thecasterian/STM32-FC/Document/Protocol.xlsx

Sheet: Definitions
Abbreviation List
Abbreviation | Description
ACC | Accelerometer
GYRO | Gyroscope
MAG | Magnetometer
KF | Kalman filter
RPY | Roll, pitch, yaw angle
PWM | Pulse width modulation
RF | Radio frequency

Sheet: Protocol Structure
Protocol Structure
Position | Length | Field Name | Description | Type | Value | Note
0 | 1 | STX | Start Byte | uint8_t | 0x02
1 | 1 | TYP | Packet Type | uint8_t | 0 -- 255 | Refer to the packet type list
2 | 2 | LEN | Data Length | uint16_t | 0 -- 1023
4 | LEN | DAT | Data | - | -
LEN + 4 | 2 | CRC | Data CRC | uint16_t | 0 -- 65535 | CRC-16/MODBUS value of DAT
LEN + 6 | 1 | ETX | End Byte | uint8_t | 0x03
Total Length | LEN + 7 | - | - | - | -
Packet Type List
TYP | Definition |  | Description
0x90 | TYP_CMD |  | Command packet
0x91 | TYP_RESP |  | Response packet
0x92 | TYP_STRM |  | Streaming packet

Sheet: Command Packet
Data Structure
Position | Length | Field Name | Description | Type | Value | Note
0 | 1 | CMD | Command ID | uint8_t | 0 -- 255 | Refer to the command list
1 | LEN - 1 | ARG | Arguments | - | -
Command List
CMD | ARG
 | Length | Definition | Description | Type | Value | Note
0xA0 | 1 | CMD_PWM | PWM on/off | bool | 0, 1 | 0: off; 1: on default: off
0xA1 | 8 | CMD_THROT | Front left throttle | uint8_t | 0 -- 100 | Unit: % default: All 0%
 |  |  | Front right throttle
 |  |  | Rear left throttle
 |  |  | Rear right throttle

Sheet: Response Packet
Data Structure
Position | Length | Field Name | Description | Type | Value | Note
0 | 1 | ERR | Error code | uint8_t | 0 -- 255 | Refer to the error code list
Error Code List
Error Code |  | Definition |  | Description
0xE0 |  | ERR_OK |  | No error Only for ACK | No errorOnly for ACK | No errorOnly for ACK
0xE1 |  | ERR_ETX_MIS |  | ETX is missing
0xE2 |  | ERR_CRC_MIS |  | Data CRC mismatch
0xE3 |  | ERR_TYP_INVAL |  | Packet type is invalid
0xE4 |  | ERR_CMD_INVAL |  | Command ID is invalid
0xE5 |  | ERR_LEN_INVAL |  | LEN does not match with the required number of arguments
0xE6 |  | ERR_ARG_INVAL |  | Argument value is invalid

Sheet: Streaming Packet
Data Structure
Position | Length | Field Name | Description | Type | Value | Note
0 | 1 | FNO | Number of streaming fields | uint8_t | 0 -- 255
1 | FNO | FID | Streaming field IDs | uint8_t[FNO] | -
FNO + 1 | LEN - FNO - 1 | SRD | Streaming data | - | - | Refer to the streaming field list
Streaming Field List
Field ID | Length | Definition | Description | Data Type | Unit | Note
0x00 | 1 | DAT_MODE | Current mode | uint8_t | -
0x01 | 4 | DAT_TICK | Current tick | uint32_t | -
0x10 | 12 | DAT_ACC | Acceleration | float[3] | m/s2
0x11 | 12 | DAT_ANG | Angular velocity | float[3] | rad/s
0x12 | 12 | DAT_MAG | Magnetic field | float[3] | uT
0x18 | 12 | DAT_RAW_ACC | Raw acceleration | float[3] | m/s2 | Raw ACC measurement without calibration in sensor frame
0x19 | 12 | DAT_RAW_ANG | Raw angular velocity | float[3] | rad/s | Raw GYRO measurement without calibration in sensor frame
0x1A | 12 | DAT_RAW_MAG | Raw magnetic field | float[3] | uT | Raw MAG measurement without calibration in sensor frame
0x20 | 16 | DAT_KF_QUAT | Kalman-filtered quaternion | float[4] | -
0x21 | 12 | DAT_KF_RPY | Kalman-filtered roll, pitch, yaw | float[3] | rad
0x28 | 16 | DAT_MEAS_QUAT | Measured quaternion | float[4] | - | Quaternion calculated from ACC and MAG measurements
0x29 | 12 | DAT_MEAS_RPY | Measured roll, pitch, yaw | float[3] | rad | RPY calculated from ACC and MAG measurements
0x30 | 40 | DAT_COV_STATE | Covariance matrix of state estimate | float[10] | - | Only upper triangular part; row major order
0x31 | 40 | DAT_COV_PROC | Covariance matrix of process noise | float[10] | - | Only upper triangular part; row major order
0x40 | 32 | DAT_RF | RF received data channel 1 -- 16 | uint16_t[16] | -
