thecasterian/STM32-FC/Hardware/Rev_B/Custom_Parts/LIS2MDLTR.step

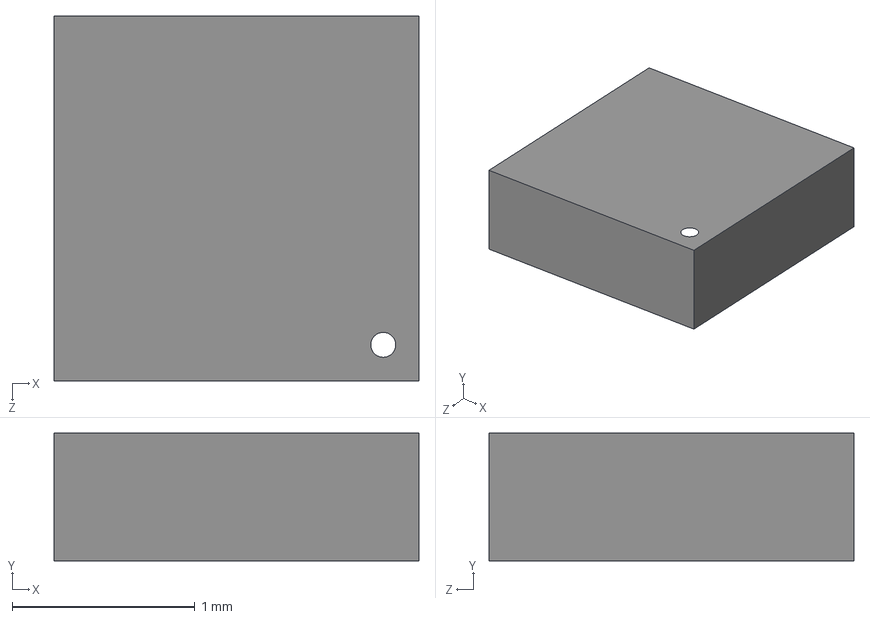
[picture p1: CAD file, 2022-11-16]
Hardware/Rev_B/Custom_Parts/LIS2MDLTR.step
2.00 x 0.7 x 2.00 mm
