thecasterian/STM32-FC/Hardware/Rev_B/Custom_Parts/BMI088.step

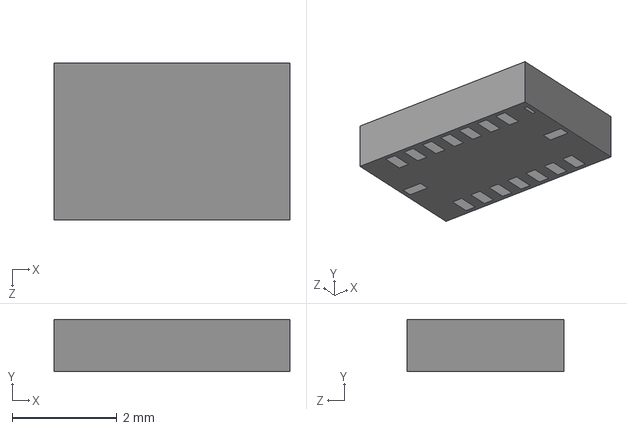
[picture p2: CAD file, 2022-11-16]
Hardware/Rev_B/Custom_Parts/BMI088.step
4.50 x 1.00 x 3.00 mm
