thecasterian/STM32-FC/Hardware/Rev_B/Custom_Parts/TS-1187A-B-A-B.step

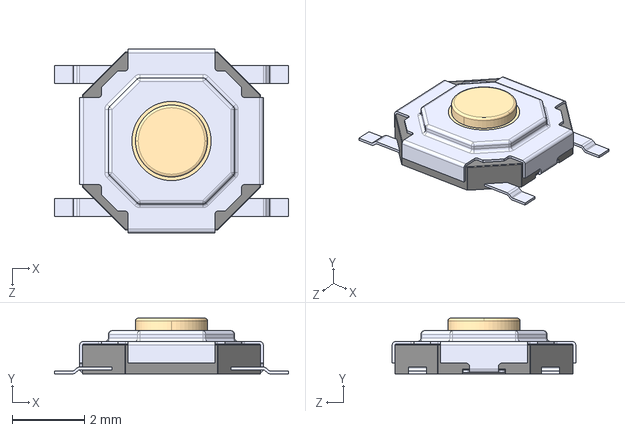
[picture p3: CAD file, 2022-11-16]
Hardware/Rev_B/Custom_Parts/TS-1187A-B-A-B.step
6.50 x 1.55 x 5.10 mm
