thecasterian/STM32-FC/Hardware/Rev_B/Custom_Parts/530480310.stp

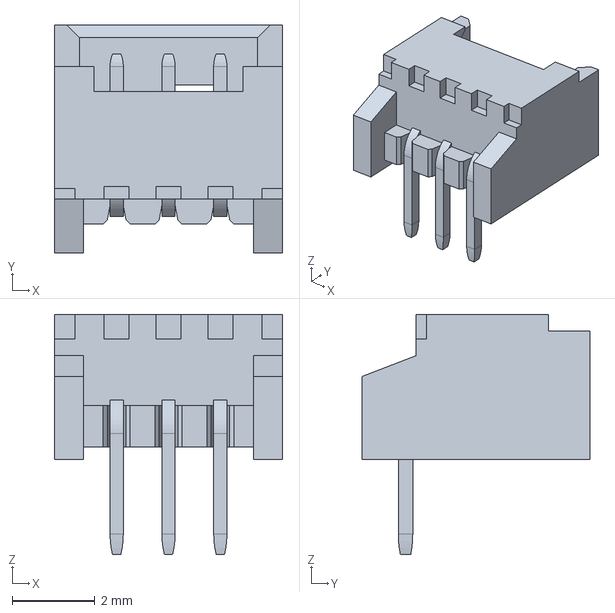
[picture p4: CAD file, 2022-12-27]
Hardware/Rev_B/Custom_Parts/530480310.stp
5.50 x 5.50 x 5.80 mm
