thecasterian/STM32-FC/Hardware/Rev_B/Custom_Parts/1050170001.stp

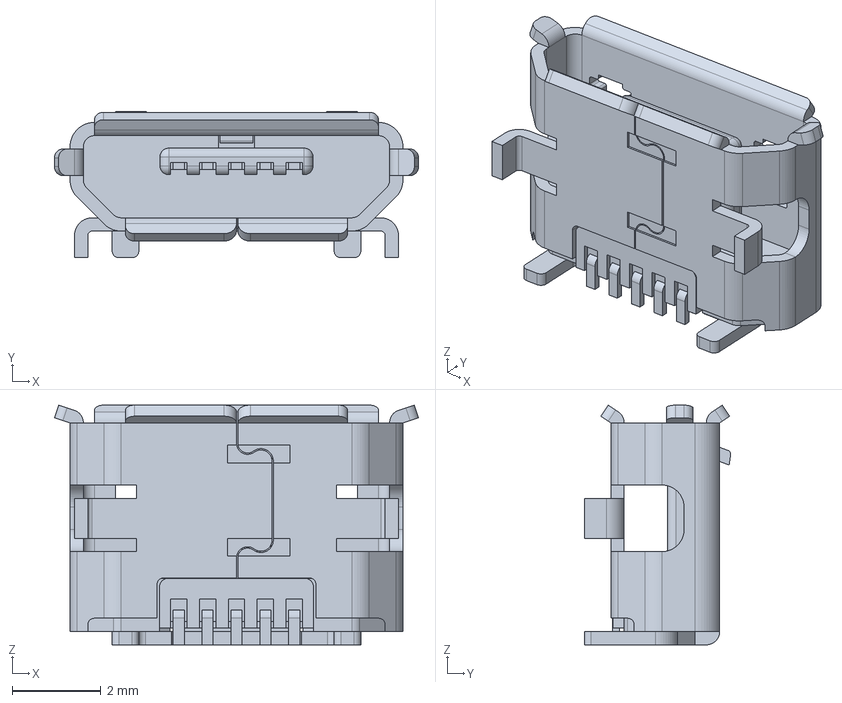
[picture p5: CAD file, 2022-11-16]
Hardware/Rev_B/Custom_Parts/1050170001.stp
8.20 x 3.30 x 5.40 mm
