thecasterian/STM32-FC/Hardware/Rev_B/STM32-FC.kicad_pcb

## KiCad design Hardware/Rev_B/STM32-FC.kicad_pcb (2022-12-27)

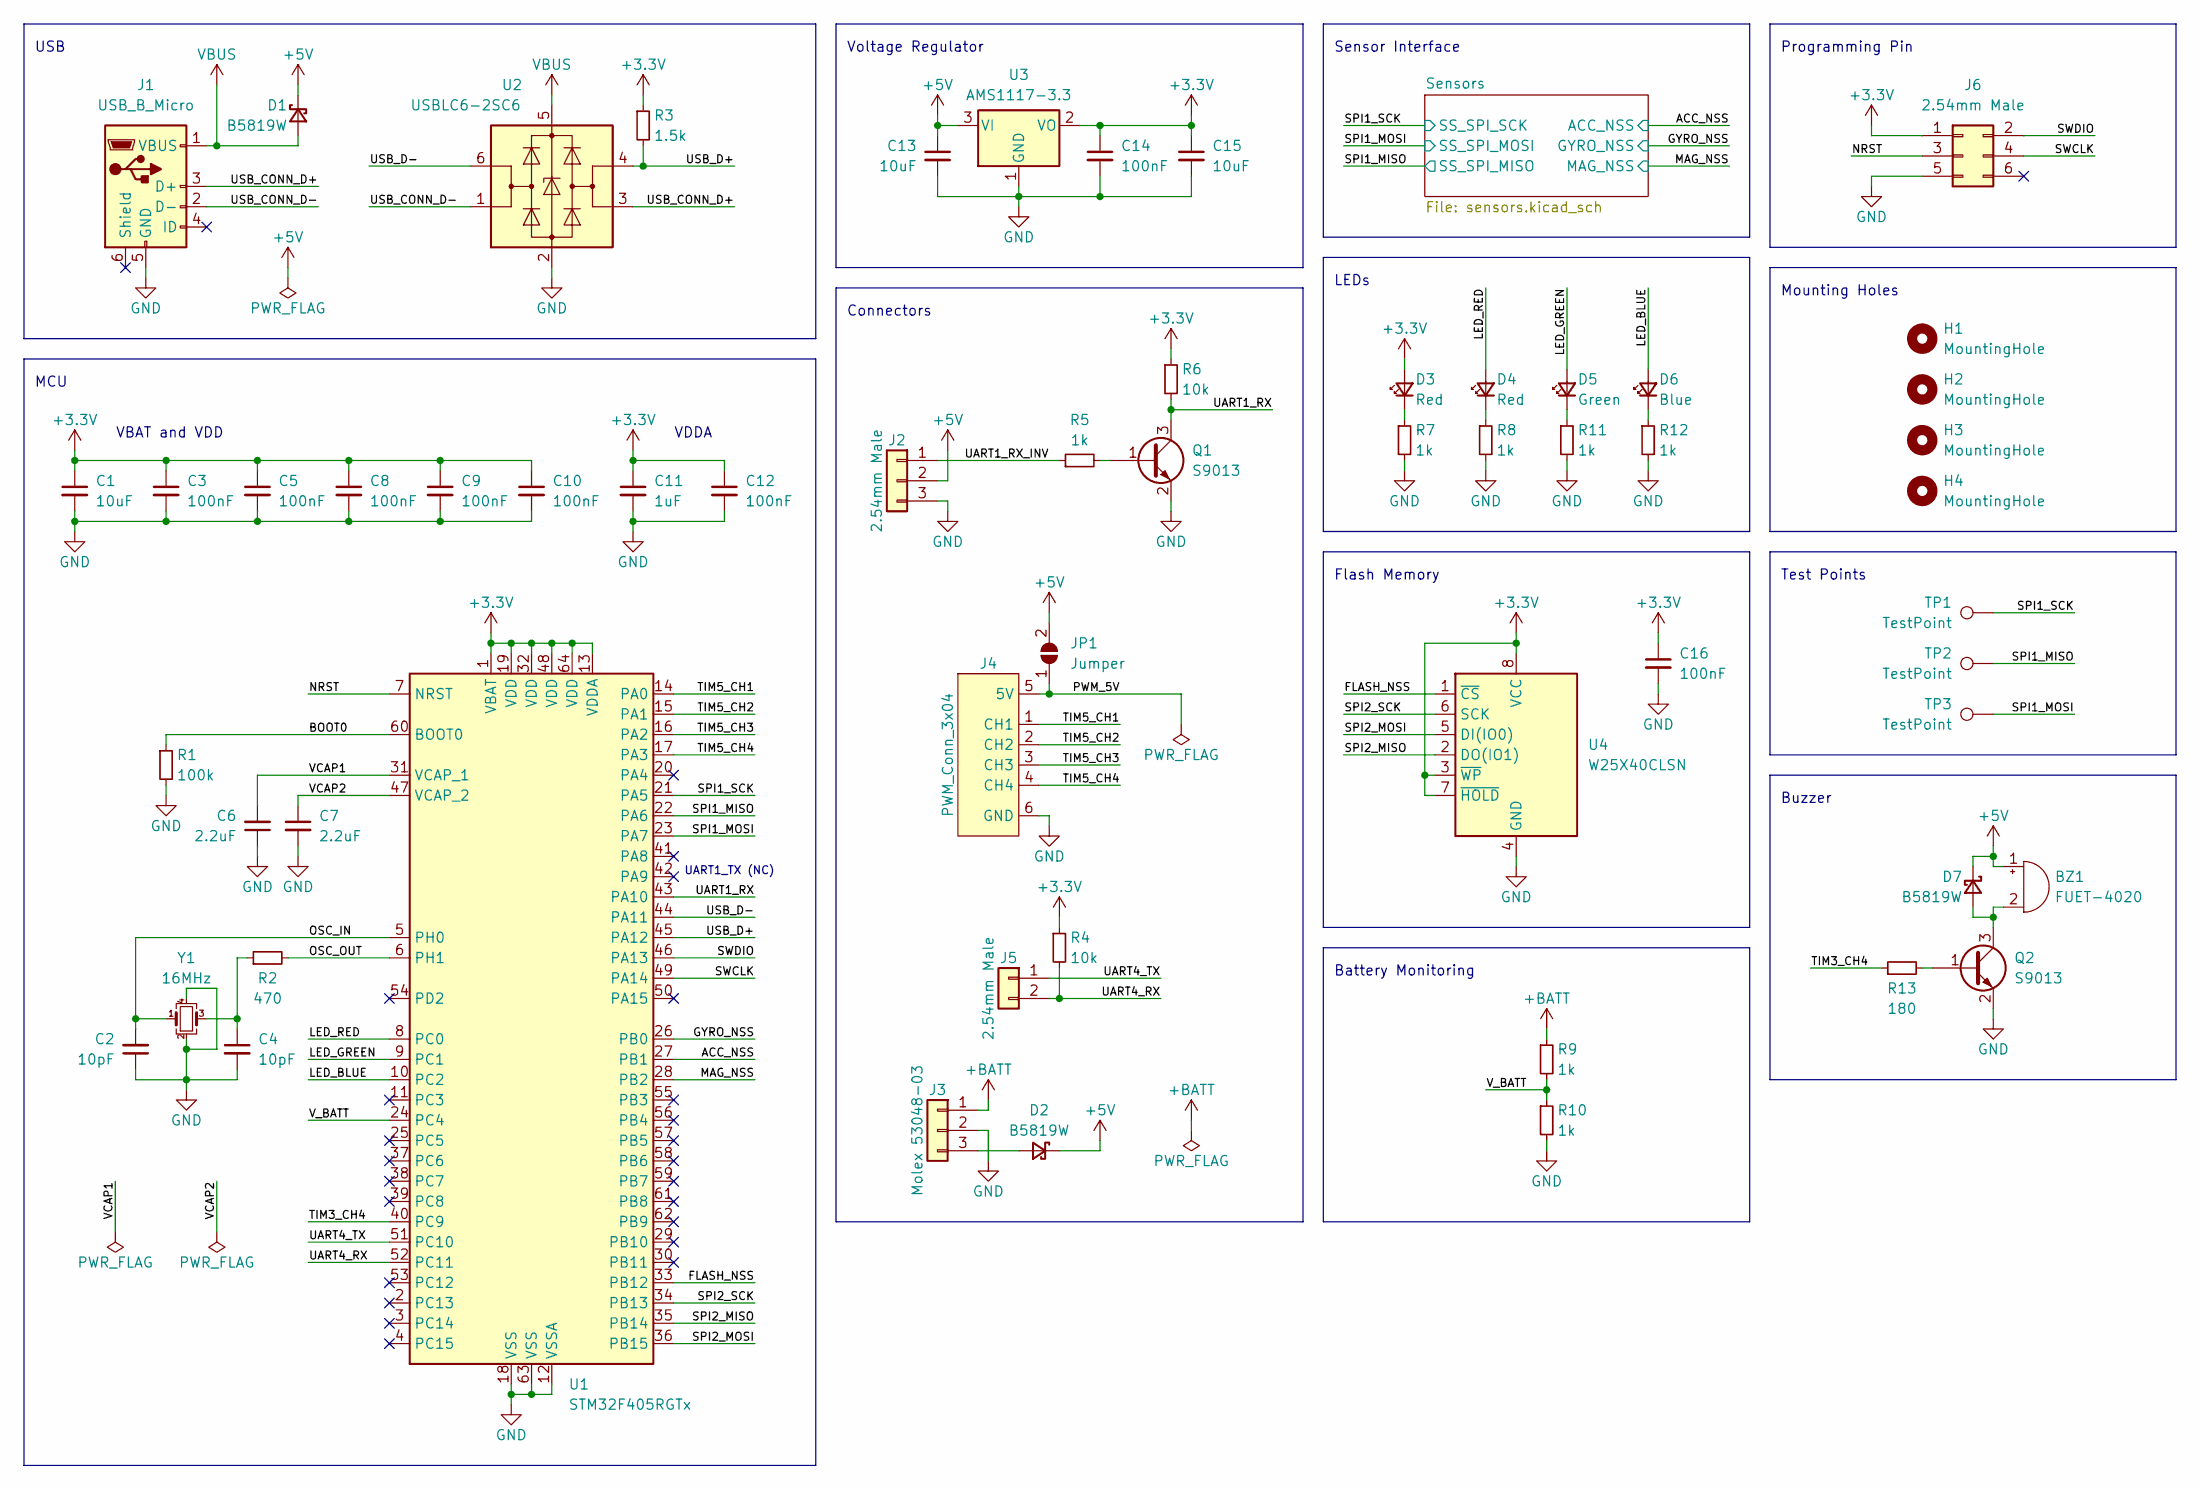
[picture p6: schematic STM32-FC.kicad_sch, STM32 Flight Controller]

Parts:
BZ1: FUET-4020
C1: 10uF; C_0402_1005Metric; LCSC C19702
C2, C4: 10pF; C_0402_1005Metric
C3, C5, C8, C9, C10, C12: 100nF; C_0402_1005Metric; LCSC C1525
C6, C7: 2.2uF; C_0402_1005Metric
C11: 1uF; C_0402_1005Metric; LCSC C1525
C13, C15: 10uF; C_0402_1005Metric
C14, C16: 100nF; C_0402_1005Metric
D1, D2: B5819W; D_SOD-123; LCSC C8598
D3, D4: Red; LED_0603_1608Metric
D5: Green; LED_0603_1608Metric
D6: Blue; LED_0603_1608Metric
D7: B5819W; D_SOD-123
H1, H2, H3, H4: MountingHole; MountingHole_3.2mm_M3
J1: USB_B_Micro; USB_Micro-B_Molex-105017-0001
J2: 2.54mm Male; PinHeader_1x03_P2.54mm_Vertical
J3: Molex 53048-03; Molex_PicoBlade_53048-0310_1x03_P1.25mm_Horizontal
J4: PWM_Conn_3x04
J5: 2.54mm Male; PinHeader_1x02_P2.54mm_Vertical
J6: 2.54mm Male; PinHeader_2x03_P2.54mm_Vertical
JP1: Jumper; SolderJumper-2_P1.3mm_Open_TrianglePad1.0x1.5mm
Q1, Q2: S9013; SOT-23-3
R1: 100k; R_0402_1005Metric
R2: 470; R_0402_1005Metric
R3: 1.5k; R_0402_1005Metric
R4, R6: 10k; R_0402_1005Metric
R5, R7, R8, R9, R10, R11, R12: 1k; R_0402_1005Metric
R13: 180; R_0402_1005Metric
TP1, TP2, TP3: TestPoint; TestPoint_Pad_D1.0mm
U1: STM32F405RGTx; LQFP-64_10x10mm_P0.5mm
U2: USBLC6-2SC6; SOT-23-6
U3: AMS1117-3.3; SOT-223-3_TabPin2; LCSC C6186
U4: W25X40CLSN; SOIC-8_3.9x4.9mm_P1.27mm
Y1: 16MHz; Crystal_SMD_Abracon_ABM8G-4Pin_3.2x2.5mm

Connections:
+3.3V: C1.1, C3.1, C5.1, C8.1, C9.1, C10.1, C11.1, C12.1, C14.1, C15.1, C16.1, D3.2 (A), J6.1, R3.1, R4.1, R6.1, U1.1 (VBAT), U1.13 (VDDA), U1.19 (VDD), U1.32 (VDD), U1.48 (VDD), U1.64 (VDD), U3.2 (VO), U4.3 (~WP), U4.7 (~HOLD), U4.8 (VCC); also elsewhere on the board
+5V: BZ1.1 (-), C13.1, D1.1 (K), D2.1 (K), D7.1 (K), J2.2, JP1.2 (B), U3.3 (VI)
+BATT: J3.1, R9.1
/ACC_NSS: U1.27 (PB1); also elsewhere on the board
/BOOT0: R1.1, U1.60 (BOOT0)
/FLASH_NSS: U1.33 (PB12), U4.1 (~CS)
/GYRO_NSS: U1.26 (PB0); also elsewhere on the board
/LED_BLUE: D6.2 (A), U1.10 (PC2)
/LED_GREEN: D5.2 (A), U1.9 (PC1)
/LED_RED: D4.2 (A), U1.8 (PC0)
/MAG_NSS: U1.28 (PB2); also elsewhere on the board
/NRST: J6.3, U1.7 (NRST)
/OSC_IN: C2.2, U1.5 (PH0), Y1.1
/OSC_OUT: R2.2, U1.6 (PH1)
/PWM_5V: J4.5 (5V), JP1.1 (A)
/SPI1_MISO: TP2.1, U1.22 (PA6); also elsewhere on the board
/SPI1_MOSI: TP3.1, U1.23 (PA7); also elsewhere on the board
/SPI1_SCK: TP1.1, U1.21 (PA5); also elsewhere on the board
/SPI2_MISO: U1.35 (PB14), U4.2 (DO(IO1))
/SPI2_MOSI: U1.36 (PB15), U4.5 (DI(IO0))
/SPI2_SCK: U1.34 (PB13), U4.6 (SCK)
/SWCLK: J6.4, U1.49 (PA14)
/SWDIO: J6.2, U1.46 (PA13)
/TIM3_CH4: R13.1, U1.40 (PC9)
/TIM5_CH1: J4.1 (CH1), U1.14 (PA0)
/TIM5_CH2: J4.2 (CH2), U1.15 (PA1)
/TIM5_CH3: J4.3 (CH3), U1.16 (PA2)
/TIM5_CH4: J4.4 (CH4), U1.17 (PA3)
/UART1_RX: Q1.3 (C), R6.2, U1.43 (PA10)
/UART1_RX_INV: J2.1, R5.1
/UART4_RX: J5.2, R4.2, U1.52 (PC11)
/UART4_TX: J5.1, U1.51 (PC10)
/USB_CONN_D+: J1.3 (D+), U2.3 (I/O2)
/USB_CONN_D-: J1.2 (D-), U2.1 (I/O1)
/USB_D+: R3.2, U1.45 (PA12), U2.4 (I/O2)
/USB_D-: U1.44 (PA11), U2.6 (I/O1)
/VCAP1: C6.2, U1.31 (VCAP_1)
/VCAP2: C7.1, U1.47 (VCAP_2)
/V_BATT: R9.2, R10.1, U1.24 (PC4)
GND: C1.2, C2.1, C3.2, C4.2, C5.2, C6.1, C7.2, C8.2, C9.2, C10.2, C11.2, C12.2, C13.2, C14.2, C15.2, C16.2, J1.5 (GND), J2.3, J3.2, J4.6 (GND), J6.5, Q1.2 (E), Q2.2 (E), R1.2, R7.2, R8.2, R10.2, R11.2, R12.2, U1.12 (VSSA), U1.18 (VSS), U1.63 (VSS), U2.2 (GND), U3.1 (GND), U4.4 (GND), Y1.2, Y1.4; also elsewhere on the board
unnamed: BZ1.2 (+), D7.2 (A), Q2.3 (C)
unnamed: C4.1, R2.1, Y1.3
unnamed: D2.2 (A), J3.3
unnamed: D3.1 (K), R7.1
unnamed: D4.1 (K), R8.1
unnamed: D5.1 (K), R11.1
unnamed: D6.1 (K), R12.1
unnamed: Q1.1 (B), R5.2
unnamed: Q2.1 (B), R13.2
VBUS: D1.2 (A), J1.1 (VBUS), U2.5 (VBUS)

Notes on the sheet:
Connectors
Voltage Regulator
Test Points
UART1_TX (NC)
LEDs
Sensor Interface
MCU
VDDA
Battery Monitoring
Buzzer
Programming Pin
USB
Flash Memory
VBAT and VDD
Mounting Holes

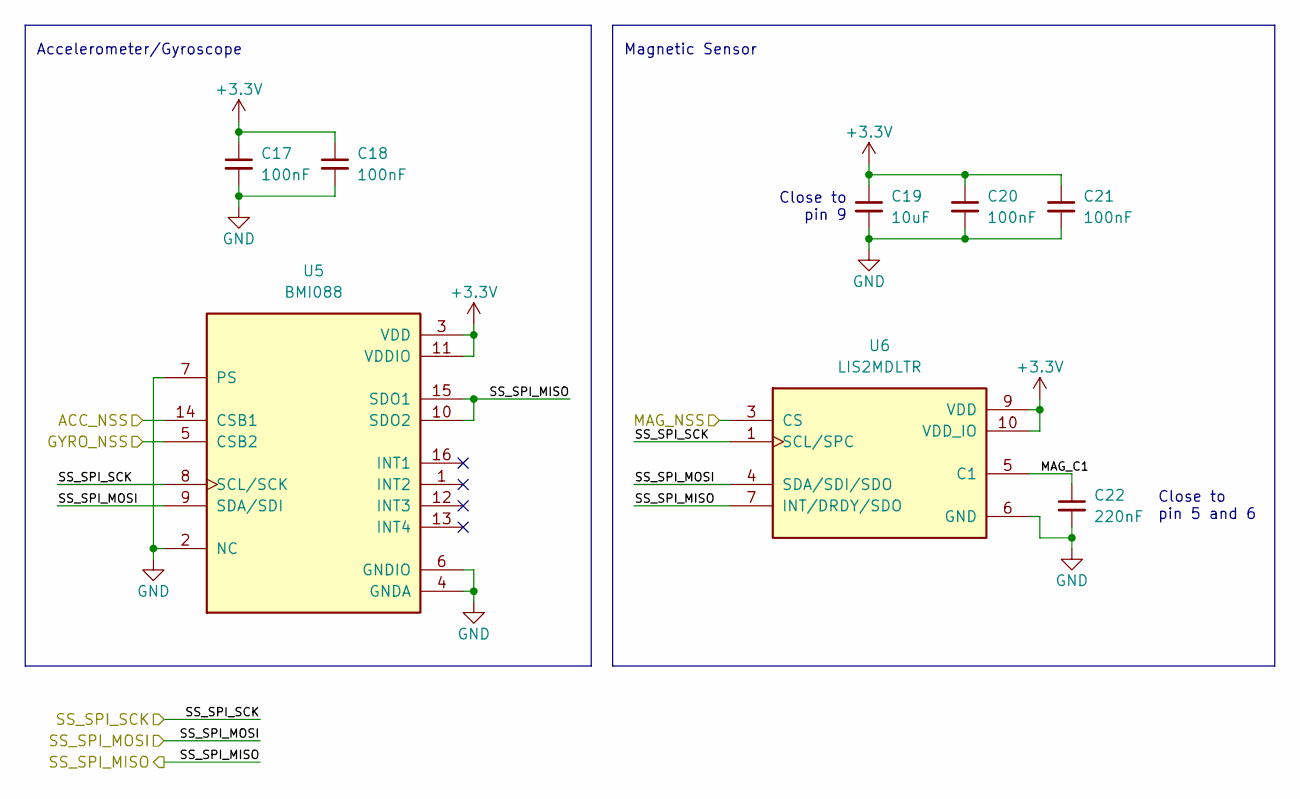
[picture p7: schematic sensors.kicad_sch, STM32 Flight Controller]

Parts:
C17, C18, C20, C21: 100nF; C_0402_1005Metric; LCSC C1525
C19: 10uF; C_0402_1005Metric; LCSC C1525
C22: 220nF; C_0402_1005Metric; LCSC C1525
U5: BMI088; PQFN50P450X300X100-16N
U6: LIS2MDLTR; PQFN50P200X200X70-12N; PARTREV Rev 5

Connections:
+3.3V: C17.1, C18.1, C19.1, C20.1, C21.1, U5.3 (VDD), U5.11 (VDDIO), U6.9 (VDD), U6.10 (VDD_IO); also elsewhere on the board
/ACC_NSS: U5.14 (CSB1); also elsewhere on the board
/GYRO_NSS: U5.5 (CSB2); also elsewhere on the board
/MAG_NSS: U6.3 (CS); also elsewhere on the board
/SPI1_MISO: U5.10 (SDO2), U5.15 (SDO1), U6.7 (INT/DRDY/SDO); also elsewhere on the board
/SPI1_MOSI: U5.9 (SDA/SDI), U6.4 (SDA/SDI/SDO); also elsewhere on the board
/SPI1_SCK: U5.8 (SCL/SCK), U6.1 (SCL/SPC); also elsewhere on the board
/Sensors/MAG_C1: C22.1, U6.5 (C1)
GND: C17.2, C18.2, C19.2, C20.2, C21.2, C22.2, U5.2 (NC), U5.4 (GNDA), U5.6 (GNDIO), U5.7 (PS), U6.6 (GND), U6.8 (GND); also elsewhere on the board

Notes on the sheet:
Close to pin 9
Magnetic Sensor
Accelerometer/Gyroscope
Close to pin 5 and 6

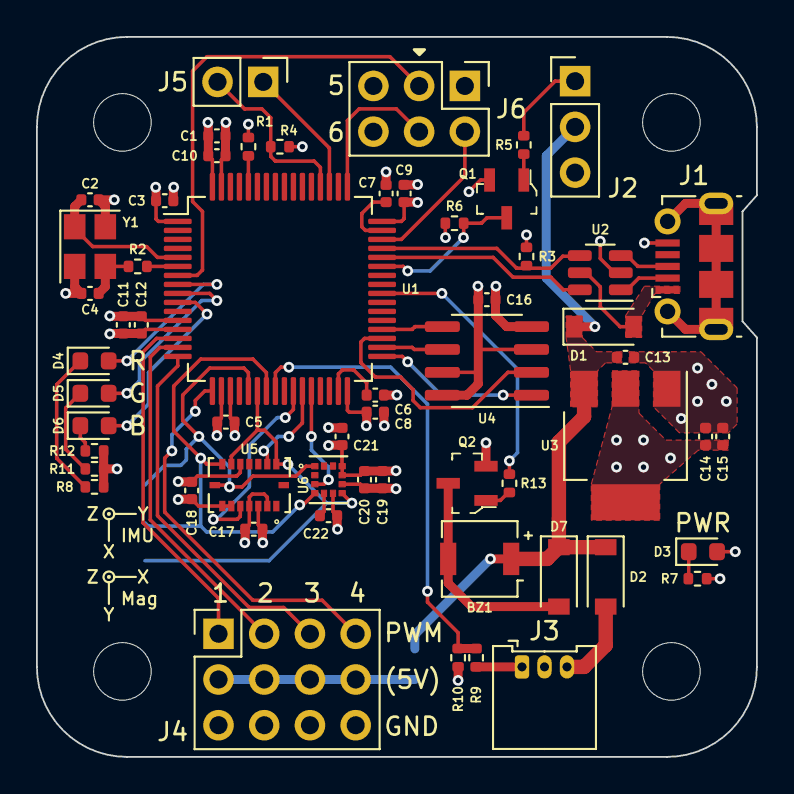
[picture p8: board STM32-FC.kicad_pcb from above]

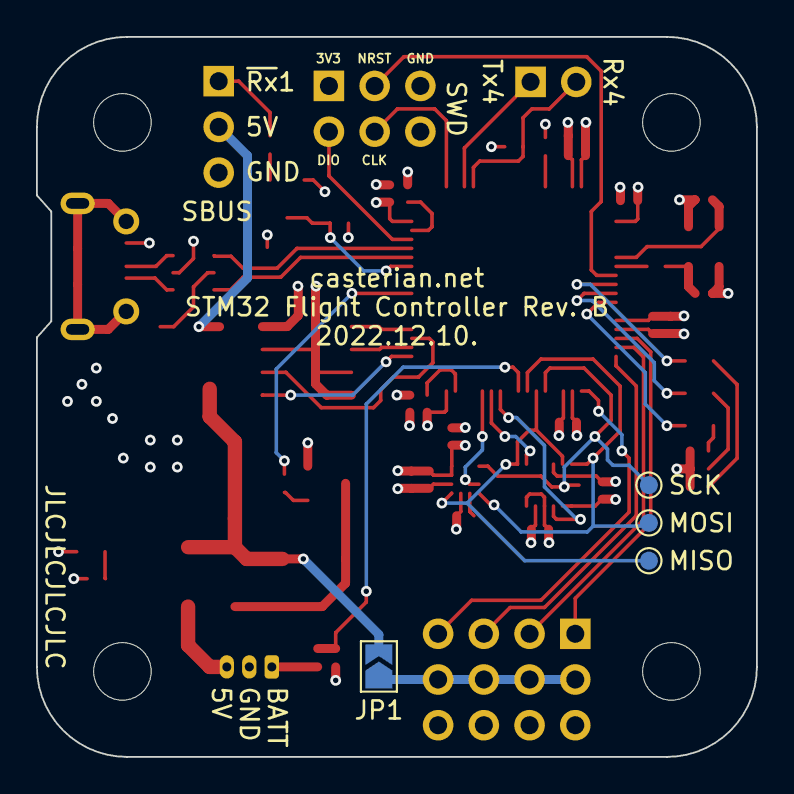
[picture p9: board STM32-FC.kicad_pcb from below]

Board: 4 copper layers, 40.0 x 40.0 mm, 66 parts (4 on the bottom side), 51 nets.
