thecasterian/STM32-FC/Firmware/STM32-FC.ioc

Mcu.UserName=STM32F405RGTx
PA0-WKUP.Signal=S_TIM5_CH1
PA1.Signal=S_TIM5_CH2
PA10.Signal=USART1_RX
PA11.Signal=USB_OTG_FS_DM
PA12.Signal=USB_OTG_FS_DP
PA13.Signal=SYS_JTMS-SWDIO
PA14.Signal=SYS_JTCK-SWCLK
PA2.Signal=S_TIM5_CH3
PA3.Signal=S_TIM5_CH4
PA5.Signal=SPI1_SCK
PA6.Signal=SPI1_MISO
PA7.Signal=SPI1_MOSI
PA9.Signal=USART1_TX
PB0.GPIO_Label=GYRO_NSS
PB0.Signal=GPIO_Output
PB1.GPIO_Label=ACC_NSS
PB1.Signal=GPIO_Output
PB10.GPIO_Label=BARO_NSS
PB10.Signal=GPIO_Output
PB12.GPIO_Label=FLASH_NSS
PB12.Signal=GPIO_Output
PB13.Signal=SPI2_SCK
PB14.Signal=SPI2_MISO
PB15.Signal=SPI2_MOSI
PB2.GPIO_Label=MAG_NSS
PB2.Signal=GPIO_Output
PC0.GPIO_Label=LED_RED
PC0.Signal=GPIO_Output
PC1.GPIO_Label=LED_GREEN
PC1.Signal=GPIO_Output
PC10.Signal=UART4_TX
PC11.Signal=UART4_RX
PC2.GPIO_Label=LED_BLUE
PC2.Signal=GPIO_Output
PC4.GPIO_Label=V_BATT
PC4.Signal=ADCx_IN14
PC9.Signal=S_TIM3_CH4
PH0-OSC_IN.Signal=RCC_OSC_IN
PH1-OSC_OUT.Signal=RCC_OSC_OUT
