thecasterian/STM32-FC/Firmware/App/Inc/config.h

/**
 * @file config.h
 * @author Jeongu Kim (jeongukim@kaist.ac.kr)
 * @brief Configuration parameters.
 *
 * @copyright (c) 2022 Jeongu Kim <jeongukim@kaist.ac.kr>
 */

#ifndef CONFIG_H
#define CONFIG_H

#include "const.h"

///@{
/** Accelerometer bias. */
#define ACC_BIAS_X (0.0113836160f)
#define ACC_BIAS_Y (0.0813763646f)
#define ACC_BIAS_Z (0.0812100636f)
///@}

/** Accelerometer scale. */
#define ACC_SCALE (0.9964445827f)

///@{
/** Gyro bias. */
#define GYRO_BIAS_X ( 4.31881460e-03f)
#define GYRO_BIAS_Y (-3.06885352e-03f)
#define GYRO_BIAS_Z (-6.71779391e-04f)
///@}

///@{
/** Magnetometer soft iron calibration matrix. */
#define MAG_SOFT_IRON_XX ( 9.94427990e-01f)
#define MAG_SOFT_IRON_XY ( 1.83568371e-02f)
#define MAG_SOFT_IRON_XZ ( 6.36170031e-04f)
#define MAG_SOFT_IRON_YY ( 1.00756510e+00f)
#define MAG_SOFT_IRON_YZ (-1.39079159e-02f)
#define MAG_SOFT_IRON_ZZ ( 9.98581413e-01f)
///@}

///@{
/** Magnetometer hard iron calibration vector. */
#define MAG_HARD_IRON_X (-498.86403906f)
#define MAG_HARD_IRON_Y (-609.94047391f)
#define MAG_HARD_IRON_Z ( 243.05037387f)
///@}

/** IIR filter coefficient of the acceleration. */
#define IIR_COEFF_ACC (0.99f)
/** IIR filter coefficient of the angular veloctiy. */
#define IIR_COEFF_ANG (0.1f)
/** IIR filter coefficient of the magnetic field. */
#define IIR_COEFF_MAG (0.1f)

/** Standard deviation of the initial quaternion. */
#define STD_INIT_QUAT (0.01f)
/** Standard deviation of the accelerometer normalized. */
#define STD_ACC (0.5f)
/** Standard deviation of the gyro. */
#define STD_GYRO (0.3f)
/** Standard deviation of the magnetometer normalized. */
#define STD_MAG (0.8f)

/** Time step. */
#define DT (.001f)
/** Half of the time step. */
#define DT2 (.0005f)

/** Maximum roll target. */
#define MAX_ROLL_TARGET (5.f * PI / 180.f)
/** Maximum pitch target. */
#define MAX_PITCH_TARGET (5.f * PI / 180.f)
/** Maximum yaw rate target. */
#define MAX_YAW_RATE_TARGET (45.f * PI / 180.f)

/** PID gains for the roll and pitch. */
#define ROLL_PITCH_P_GAIN (0.0f)
#define ROLL_PITCH_I_GAIN (0.0f)
#define ROLL_PITCH_D_GAIN (0.1f)
/** PID gains for the yaw rate. */
#define YAW_RATE_P_GAIN (0.0f)
#define YAW_RATE_I_GAIN (0.0f)

#endif
