thecasterian/STM32-FC/GroundControl/Inc/main_window.hpp

#ifndef MAIN_WINDOW_HPP
#define MAIN_WINDOW_HPP

#include <QMainWindow>
#include "command_tab.hpp"
#include "plot_tab.hpp"
#include "port_tab.hpp"
#include "sample_counter.hpp"

namespace Ui
{
class MainWindow;
}

class MainWindow : public QMainWindow
{
public:
    explicit MainWindow(QWidget *parent = nullptr);
    ~MainWindow();

private:
    Ui::MainWindow *ui;

    PortManager *port_mgr;
    PlotManager *plot_mgr;
    CommandManager *cmd_mgr;

    PortTab *port_tab;
    CommandTab *command_tab;
    PlotTab *plot_tab;

    QLabel *err_label, *smp_label;
    SampleCounter *smp_counter;
};

#endif
