thecasterian/STM32-FC/GroundControl/Src/main.cpp

#include <QApplication>
#include "../Inc/main_window.hpp"

int main(int argc, char *argv[])
{
    QApplication app(argc, argv);

    MainWindow *window = new MainWindow();
    window->show();

    return app.exec();
}
