thecasterian/STM32-FC/Firmware/App/Src/ring_buffer.c

#include <string.h>
#include "ring_buffer.h"
#include "util.h"

void ring_buffer_push(ring_buffer_t *ringbuf, uint8_t *buf, uint16_t size) {
    if ((ringbuf->tail + size) < RING_BUFFER_SIZE) {
        memcpy_to_volatile(&ringbuf->buf[ringbuf->tail], &buf[0], size);
        ringbuf->tail += size;
    } else {
        uint16_t size1 = RING_BUFFER_SIZE - ringbuf->tail;
        uint16_t size2 = size - size1;
        memcpy_to_volatile(&ringbuf->buf[ringbuf->tail], &buf[0], size1);
        memcpy_to_volatile(&ringbuf->buf[0], &buf[size1], size2);
        ringbuf->tail = size2;
    }
}

bool ring_buffer_pop(ring_buffer_t *ringbuf, uint8_t *buf, uint16_t size) {
    bool success;

    if (ringbuf->head <= ringbuf->tail) {
        if ((ringbuf->tail - ringbuf->head) < size) {
            success = false;
        } else {
            memcpy_from_volatile(&buf[0], &ringbuf->buf[ringbuf->head], size);
            ringbuf->head += size;
            success = true;
        }
    } else {
        if ((RING_BUFFER_SIZE - ringbuf->head + ringbuf->tail) < size) {
            success = false;
        } else if ((ringbuf->head + size) < RING_BUFFER_SIZE) {
            memcpy_from_volatile(&buf[0], &ringbuf->buf[ringbuf->head], size);
            ringbuf->head += size;
            success = true;
        } else {
            uint16_t size1 = RING_BUFFER_SIZE - ringbuf->head;
            uint16_t size2 = size - size1;
            memcpy_from_volatile(&buf[0], &ringbuf->buf[ringbuf->head], size1);
            memcpy_from_volatile(&buf[size1], &ringbuf->buf[0], size2);
            ringbuf->head = size2;
            success = true;
        }
    }

    return success;
}
