thecasterian/STM32-FC/Firmware/App/Inc/const.h

/**
 * @file const.h
 * @author Jeongu Kim (jeongukim@kaist.ac.kr)
 * @brief Constants.
 *
 * @copyright (c) 2022 Jeongu Kim <jeongukim@kaist.ac.kr>
 */

#ifndef CONST_H
#define CONST_H

/** Pi. */
#define PI 3.14159265f

/** Scale factor to convert an angle from degree to radian. */
#define DEG_TO_RAD 0.0174532925f

/** Scale factor to convert from mG to uT. */
#define MG_TO_UT 0.1f

/** Gravitational acceleration (m/s^2). */
#define ACC_GRAV 9.80665f

#endif
