thecasterian/STM32-FC/GroundControl/Inc/command_manager.hpp

#ifndef COMMAND_MANAGER_HPP
#define COMMAND_MANAGER_HPP

#include "port_manager.hpp"

class CommandManager : public QObject
{
    Q_OBJECT

public:
    explicit CommandManager(PortManager *port_mgr);

    bool setStrm(const QVector<uint8_t> &ids);
    bool toggleStrm(bool on);
    bool setThrottle(uint16_t front_left, uint16_t front_right, uint16_t rear_left, uint16_t rear_right);
    bool togglePwm(bool on);
    bool toggleDebugLed(uint8_t led, bool on);

    PortManager *getPortManager(void);

private:
    PortManager *port_mgr;

private slots:
    void receiveResp(uint8_t ack, uint8_t err);
};

#endif
