thecasterian/STM32-FC/GroundControl/Inc/port_manager.hpp

#ifndef PORT_MANAGER_HPP
#define PORT_MANAGER_HPP

#include <QObject>
#include <QtSerialPort>
#include "packet_parser.hpp"

class PortInfo
{
public:
    QString name;
    QString baud_rate;
};

class PortManager : public QObject
{
    Q_OBJECT

public:
    PortManager();
    ~PortManager();

    bool isOpen(void);
    bool open(const PortInfo &info);
    void close(void);
    bool send(uint16_t len, const uint8_t *data);

signals:
    void portClosed(void);
    void respReceived(uint8_t ack, uint8_t err);
    void strmReceived(uint8_t len, const uint8_t *dat);

private:
    QSerialPort port;
    PacketParser parser;

private slots:
    void receive(void);
    void onPortError(QSerialPort::SerialPortError error);
};

#endif
