thecasterian/STM32-FC/Firmware/App/Inc/application.h

/**
 * @file application.h
 * @author Jeongu Kim (jeongukim@kaist.ac.kr)
 * @brief Application main.
 *
 * @copyright (c) 2022 Jeongu Kim <jeongukim@kaist.ac.kr>
 */

#ifndef APPLICATION_H
#define APPLICATION_H

/**
 * @brief Initializes the program.
 */
void setup(void);

/**
 * @brief Program main loop.
 */
void loop(void);

#endif
