thecasterian/STM32-FC/(commit log)

2022-11-16 Implement timer
2022-11-16 Add hardware design files
    [1050170001.stp, BMI088.step, BOM-STM32-FC.csv, LIS2MDLTR.step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]
2022-11-23 Implement communication protocol via USB
    [Protocol.xlsx]
2022-11-25 Separate calibration routines
    [Protocol.xlsx]
2022-11-28 Update protocol and refactor streaming data
    [Protocol.xlsx]
2022-12-10 Add missing files and Remove unnecessary files
    [BOM-STM32-FC.csv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]
2022-12-10 Remove pressure sensor I/F and update protocol
2022-12-11 Update protocol documentation
    [Protocol.xlsx]
2022-12-16 Implement ESC interface
    [Protocol.xlsx]
2022-12-24 Implement mode and update protocol
    [Protocol.xlsx]
2022-12-27 Add hardware rev. B (WIP)
    [1050170001.stp, 530480310.stp, BMI088.step, LIS2MDLTR.step, STM32-FC.kicad_pcb, STM32-FC.kicad_sch, TS-1187A-B-A-B.step, sensors.kicad_sch]
2022-12-28 Add attitude estimation based on measurments
    [Protocol.xlsx]
2022-12-30 Simplify ESC interface
    [Protocol.xlsx]
2023-01-12 Imeplement EKF
    [Protocol.xlsx]
2023-01-16 Add acc. calibration and std. dev. of sensors
2023-01-17 Add external acceleration compensation algorithm
    [Protocol.xlsx]
2023-01-19 Add SBUS specification on UART1
2023-02-04 Implement SBUS parser
    [Protocol.xlsx]
2023-02-04 Change attitude estimation algorithm
    [Protocol.xlsx]
2023-02-05 Implement ground control GUI skeleton
2023-02-07 Add sample counter and buffer size slider
2023-02-07 Add motor control based on RF
    [Protocol.xlsx]
2023-02-07 Add debug LED toggle buttons
2023-02-07 Add throttle setting
2023-02-09 Implement PID controller
2023-02-10 Add motor test mode
2023-02-11 Refactor sensor drivers and AHRS
2023-02-11 Refactor FC protocol
    [Protocol.xlsx]
2023-02-12 Refactor SBUS parser
    [Protocol.xlsx]
